xmoshte/list-tap/source/v4/production/bom.csv

Designator | Footprint | Quantity | Value | LCSC Part #
B2, B3 | PESD5V5C1BLYL | 2 | PESD5V5C1BLYL(TP) | C54194967
BT1 | BAT_BK-880 | 1 | MY-2450-02 | C2979177
C1, C2 | PXTE010M477E060STU | 2 | 470u 10V | C724264
C10, C11 | CAPC1005X04L | 2 | 22u 10V | C6119813
C12, C9 | CAPC1608X06L | 2 | 10u 25V | C96446
C16, C17, C18, C19, C20 | CAPC1005X04L | 5 | 100n 50V | C53084453
C21 | CAPC1005X04L | 1 | 10u 10V | C315248
C22 | CAPC1005X04L | 1 | 1u 16V | C29266
D4 | LED_0402_GREEN | 1 | GREEN | C74338
L1 | INDC2520X100N | 1 | 470n 5.5A | C54557079
R14 | RESC1005X04L | 1 | 100k | C60491
R15 | RESC1005X04L | 1 | 511k | C64042
R16 | RESC1005X04L | 1 | 91k | C852952
R17 | RESC1005X04L | 1 | 340k | C2933090
R18 | RESC1005X04L | 1 | 120k | C2909314
R19, R20, R21, R22, R23 | RESC1005X04L | 5 | 10k | C60490
R25 | RESC1005X04L | 1 | 1k | C106235
R3, R4 | RESC1005X04L | 2 | 22R | C114765
SW1, SW2 | SW2_SKRKAEE020_ALPS | 2 | SKRKAEE020 | C115357
SW3 | PTS815 | 1 | PTS815 SJM 250 SMTR LFS | C2689510
U1 | ESP32C3MINI1N4 | 1 | ESP32-C3-MINI-1-N4 | C2838502
U3 | SOT23-6L_STM | 1 | USBLC6-2SC6Y | C2969755
U5 | BGA15N40P5X3_225X134X62N | 1 | TPS63805YFFR | C2879615
