xmoshte/list-tap/source/v4/list-tap.kicad_pcb

## KiCad design source/v4/list-tap.kicad_pcb (2026-11-05)

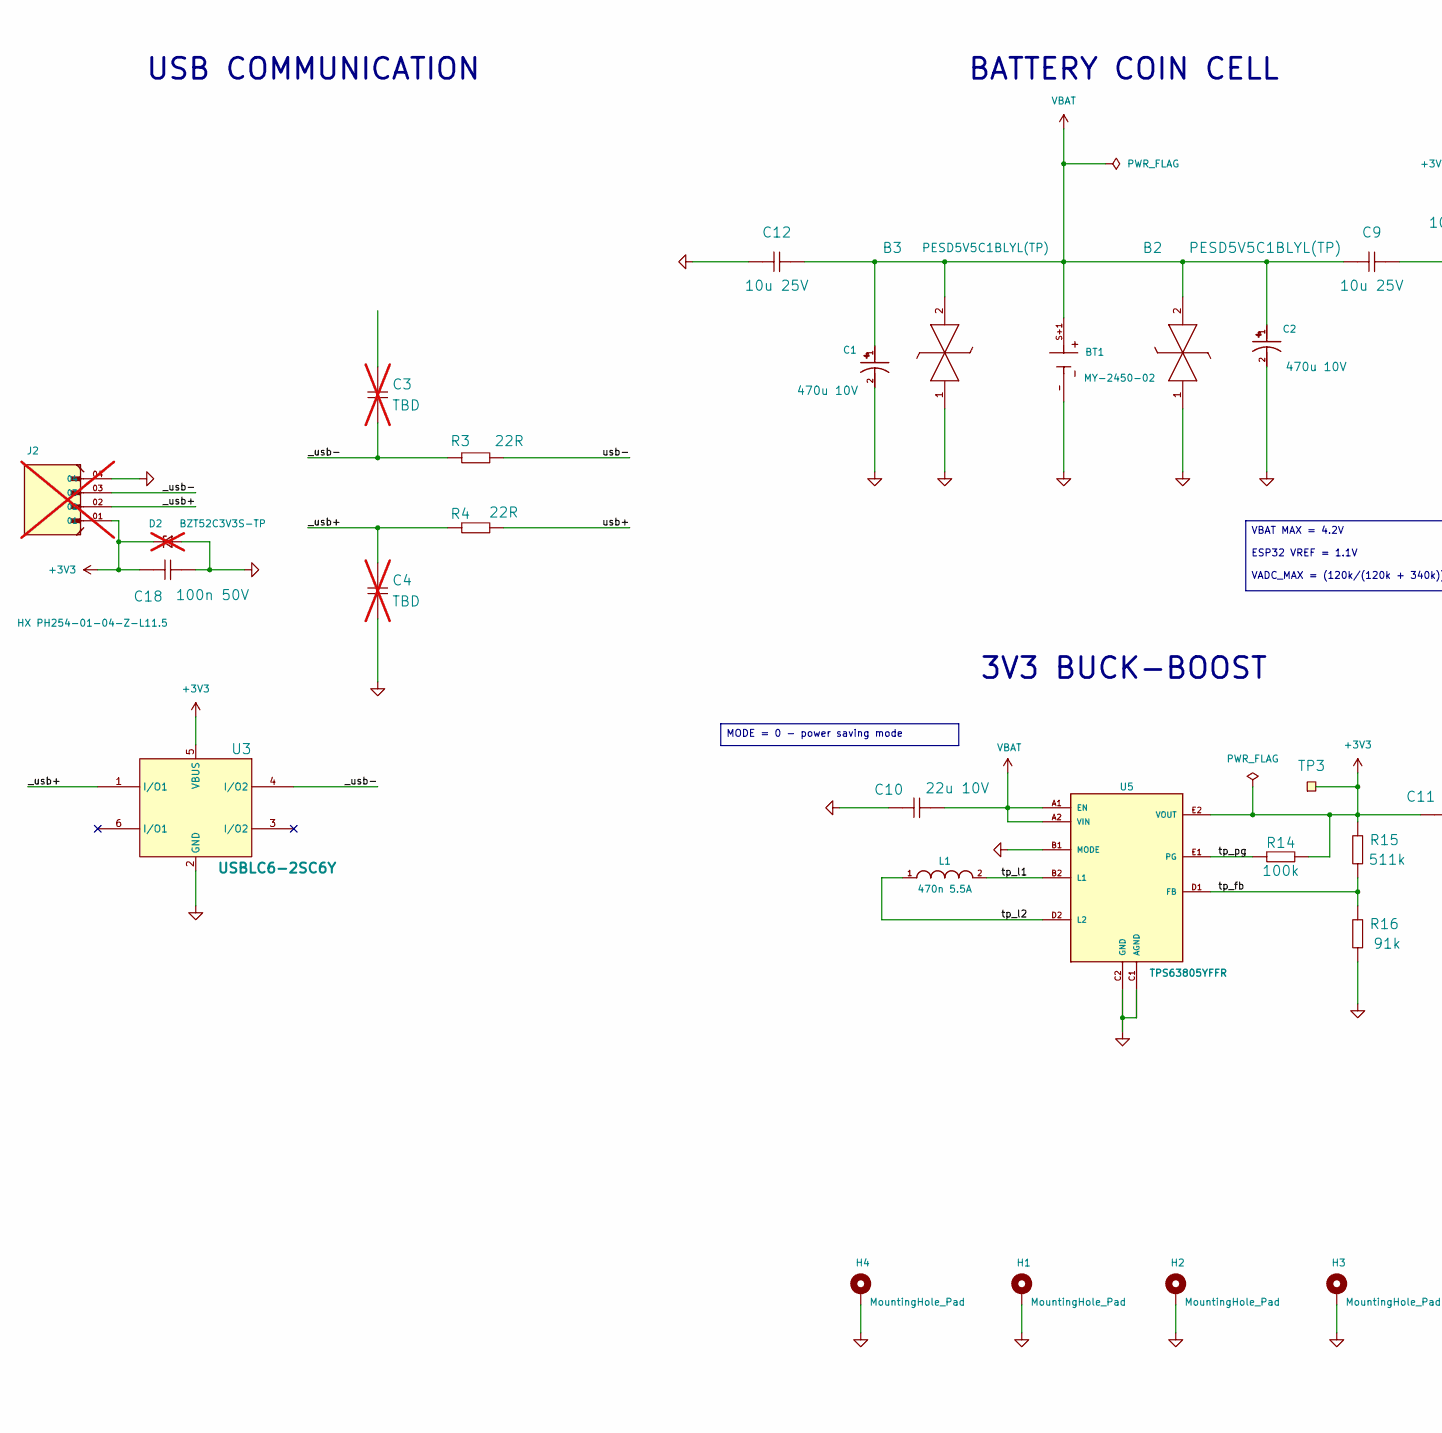
[picture p1: schematic list-tap.kicad_sch, part in row 1, column 1]

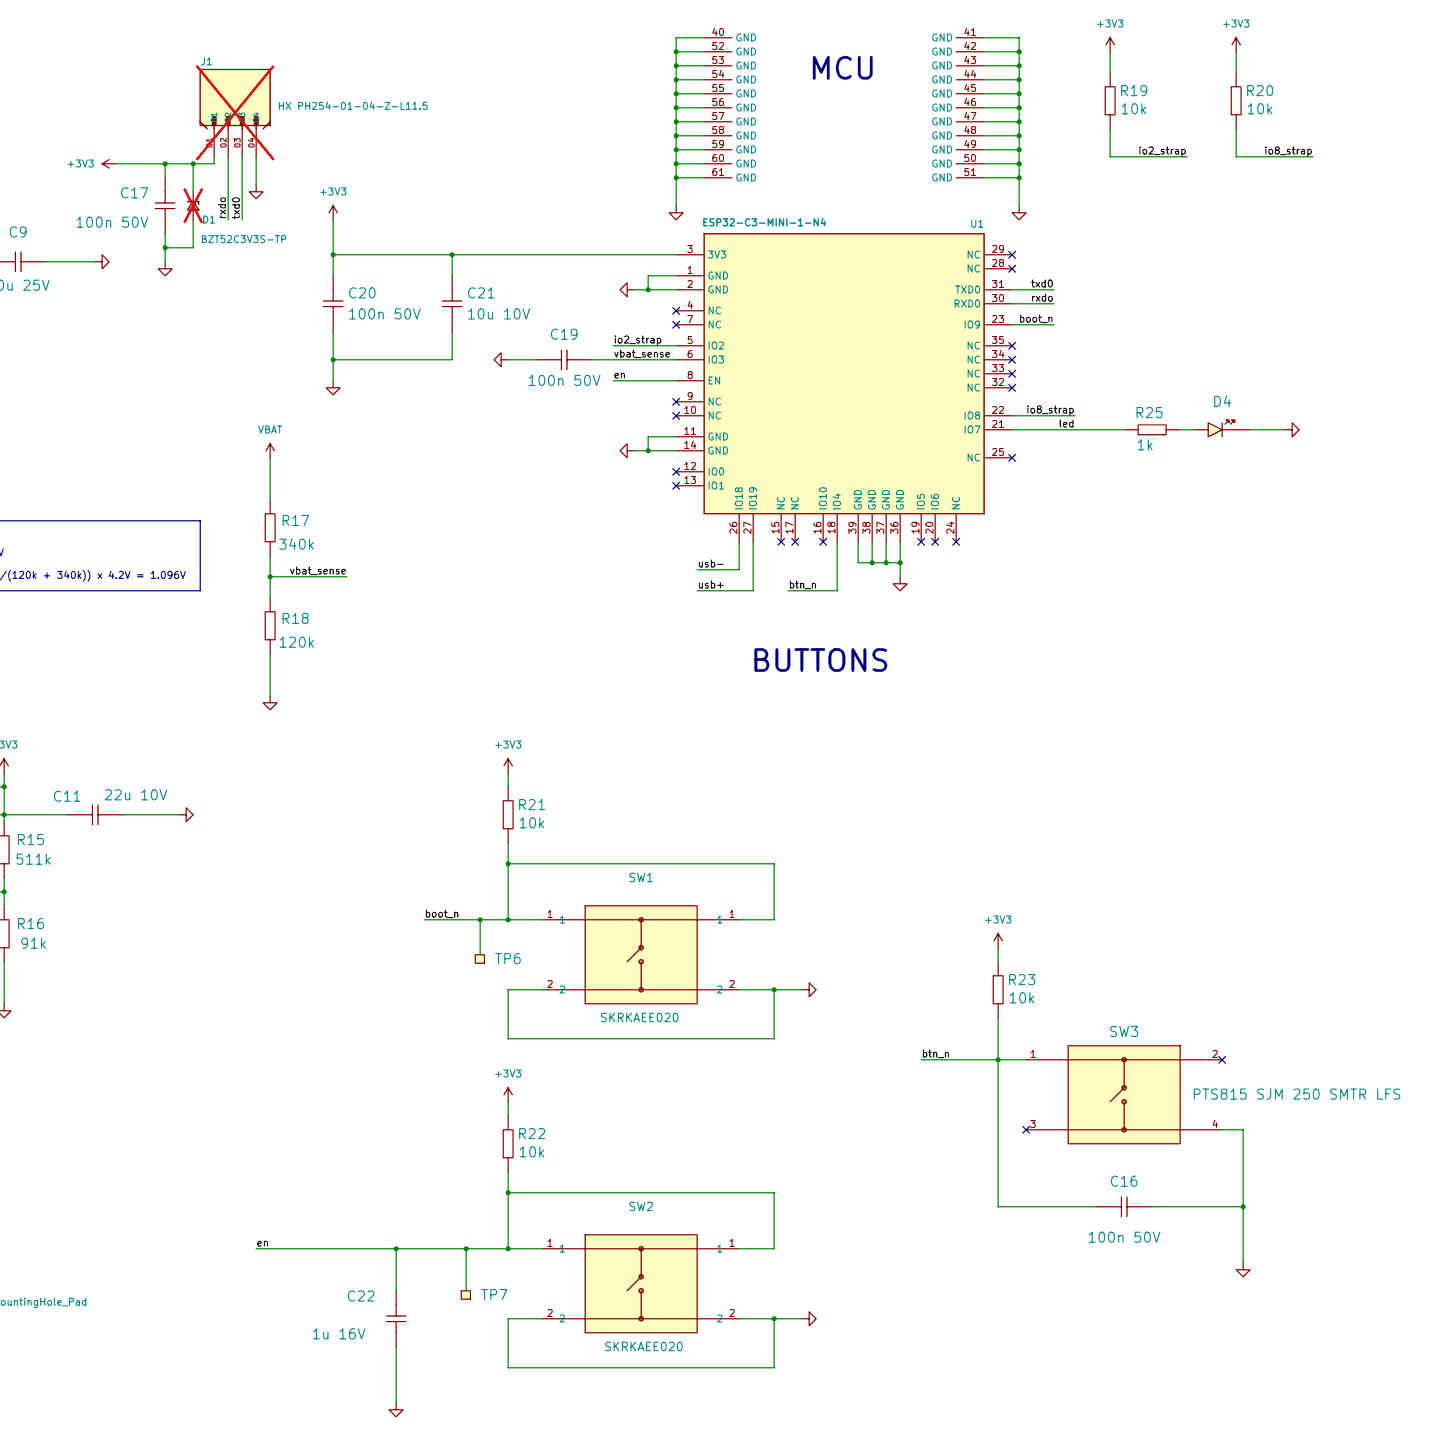
[picture p2: schematic list-tap.kicad_sch, part in row 1, column 2]

Parts:
B2, B3: PESD5V5C1BLYL(TP); PESD5V5C1BLYL; Manufacturer Part Number PESD5V5C1BLYL(TP); LCSC Part # C54194967
BT1: MY-2450-02; BAT_BK-880; Manufacturer Part Number MY-2450-02; LCSC Part # C2979177
C1, C2: 470u 10V; PXTE010M477E060STU; Manufacturer Part Number PXTE010M477E060STU; LCSC Part # C724264
C3, C4: TBD; CAPC1005X04L; not fitted
C9, C12: 10u 25V; CAPC1608X06L; Manufacturer Part Number CL10A106MA8NRNC; LCSC Part # C96446
C10, C11: 22u 10V; CAPC1005X04L; Manufacturer Part Number CGA0402X5R226M100GT; LCSC Part # C6119813
C16, C17, C18, C19, C20: 100n 50V; CAPC1005X04L; Manufacturer Part Number CC0402X7R50V104MN; LCSC Part # C53084453
C21: 10u 10V; CAPC1005X04L; Manufacturer Part Number CL05A106MP5NUNC; LCSC Part # C315248
C22: 1u 16V; CAPC1005X04L; Manufacturer Part Number CL05A105KO5NNNC; LCSC Part # C29266
D1, D2: BZT52C3V3S-TP; SOD2512X115N; Manufacturer Part Number BZT52C3V3S-TP; LCSC Part # C668900; not fitted
D4: GREEN; LED_0402_GREEN; Manufacturer Part Number 16-213/GHC-YR1S1/3T; LCSC Part # C74338
H1, H2, H3, H4: MountingHole_Pad; MountingHole_2.2mm_M2_Pad_Via
J1, J2: HX PH254-01-04-Z-L11.5; Manufacturer Part Number HX PH254-01-04-Z-L11.5; LCSC Part # C52016392; not fitted
L1: 470n 5.5A; INDC2520X100N; Manufacturer Part Number PCT252010-R47-M; LCSC Part # C54557079
R3, R4: 22R; RESC1005X04L; Manufacturer Part Number RC0402FR-0722RL; LCSC Part # C114765
R14: 100k; RESC1005X04L; Manufacturer Part Number RC0402FR-07100KL; LCSC Part # C60491
R15: 511k; RESC1005X04L; Manufacturer Part Number 0402WGF5113TCE; LCSC Part # C64042
R16: 91k; RESC1005X04L; Manufacturer Part Number RT0402BRD0791KL; LCSC Part # C852952
R17: 340k; RESC1005X04L; Manufacturer Part Number FRC0402F3403TS; LCSC Part # C2933090
R18: 120k; RESC1005X04L; Manufacturer Part Number FRC0402F1203TS; LCSC Part # C2909314
R19, R20, R21, R22, R23: 10k; RESC1005X04L; Manufacturer Part Number RC0402FR-0710KL; LCSC Part # C60490
R25: 1k; RESC1005X04L; Manufacturer Part Number RC0402FR-071KL; LCSC Part # C106235
SW1, SW2: SKRKAEE020; SW2_SKRKAEE020_ALPS; Manufacturer Part Number SKRKAEE020; LCSC Part # C115357
SW3: PTS815 SJM 250 SMTR LFS; PTS815; Manufacturer Part Number PTS815 SJM 250 SMTR LFS; LCSC Part # C2689510
TP3, TP6, TP7: Test Point; TP_SMD_D1.5mm; Part Number TP_SMD_Ø1.5MM
U1: ESP32-C3-MINI-1-N4; ESP32C3MINI1N4; Manufacturer Part Number ESP32-C3-MINI-1-N4; LCSC Part # C2838502
U3: USBLC6-2SC6Y; SOT23-6L_STM; Manufacturer Part Number USBLC6-2SC6Y; LCSC Part # C2969755
U5: TPS63805YFFR; BGA15N40P5X3_225X134X62N; Manufacturer Part Number TPS63805YFFR; LCSC Part # C2879615

Connections:
+3V3: C11.1, C17.2, C18.2, C20.2, C21.2, D1.K, D2.K, J1.01, J2.01, R14.2, R15.2, R19.2, R20.2, R21.2, R22.2, R23.2, TP3.1 (1_1), U1.3 (3V3), U3.5 (VBUS), U5.E2 (VOUT), U5.E3 (VOUT)
/_usb+: C4.2, J2.02, R4.1, U3.1 (I/O1)
/_usb-: C3.1 (1_1), J2.03, R3.1, U3.4 (I/O2)
/boot_n: R21.1, SW1.1, TP6.1 (1_1), U1.23 (IO9)
/btn_n: C16.2, R23.1, SW3.1, U1.18 (IO4)
/en: C22.1, R22.1, SW2.1, TP7.1 (1_1), U1.8 (EN)
/io2_strap: R19.1, U1.5 (IO2)
/io8_strap: R20.1, U1.22 (IO8)
/led: R25.2, U1.21 (IO7)
/rxdo: J1.02, U1.30 (RXD0)
/tp_fb: R15.1, R16.2, U5.D1 (FB)
/tp_l1: L1.2, U5.B2 (L1), U5.B3 (L1)
/tp_l2: L1.1, U5.D2 (L2), U5.D3 (L2)
/tp_pg: R14.1, U5.E1 (PG)
/txd0: J1.03, U1.31 (TXD0)
/usb+: R4.2, U1.27 (IO19)
/usb-: R3.2, U1.26 (IO18)
/vbat_sense: C19.2, R17.1, R18.2, U1.6 (IO3)
GND: B2.1 (K1), B3.1 (K1), BT1.-, C1.2, C2.2, C4.1, C9.2, C10.1, C11.2, C12.2, C16.1, C17.1, C18.1, C19.1, C20.1, C21.1, C22.2, D1.A, D2.A, D4.K, H1.1 (1_1), H2.1 (1_1), H3.1 (1_1), H4.1 (1_1), J1.04, J2.04, R16.1, R18.1, SW1.2, SW2.2, SW3.4, U1.1 (GND), U1.2 (GND), U1.11 (GND), U1.14 (GND), U1.36 (GND), U1.37 (GND), U1.38 (GND), U1.39 (GND), U1.40 (GND), U1.41 (GND), U1.42 (GND), U1.43 (GND), U1.44 (GND), U1.45 (GND), U1.46 (GND), U1.47 (GND), U1.48 (GND), U1.49 (GND), U1.50 (GND), U1.51 (GND), U1.52 (GND), U1.53 (GND), U1.54 (GND), U1.55 (GND), U1.56 (GND), U1.57 (GND), U1.58 (GND), U1.59 (GND), U1.60 (GND), U1.61 (GND), U3.2 (GND), U5.B1 (MODE), U5.C1 (AGND), U5.C2 (GND), U5.C3 (GND)
unnamed: D4.A, R25.1
VBAT: B2.2 (K2), B3.2 (K2), BT1.S+1, BT1.S+2, C1.1, C2.1, C9.1, C10.2, C12.1, R17.2, U5.A1 (EN), U5.A2 (VIN), U5.A3 (VIN)

Notes on the sheet:
3V3 BUCK-BOOST
USB COMMUNICATION
MCU
BUTTONS
BATTERY COIN CELL
VBAT MAX = 4.2V ESP32 VREF = 1.1V VADC_MAX = (120k/(120k + 340k)) x 4.2V = 1.096V
MODE = 0 - power saving mode

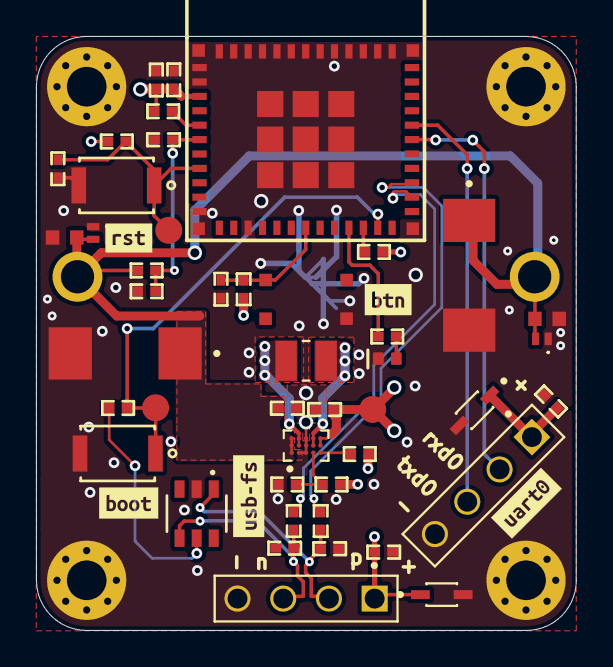
[picture p3: board list-tap.kicad_pcb from above]

Board: 2 copper layers, 30.0 x 33.0 mm, 55 parts (1 on the bottom side), 21 nets.

Other parts of the board:
kibuzzard-6AE057E3: G***; kibuzzard-6AE057E3
kibuzzard-6AE057F3: G***; kibuzzard-6AE057F3
kibuzzard-6AE0575D: G***; kibuzzard-6AE0575D
kibuzzard-6AE0576D: G***; kibuzzard-6AE0576D
kibuzzard-6AE0579C: G***; kibuzzard-6AE0579C
