xmoshte/list-tap/(commit log)

2026-10-21 schematics done awaiting revision
    [bom.csv, list-tap.kicad_sch]
2026-10-21 r2 changes
    [bom.csv, list-tap.kicad_sch]
2026-10-23 layout r1
    [bom.csv, list-tap.kicad_pcb, list-tap.kicad_sch]
2026-10-23 bom r2
    [bom.csv, list-tap.kicad_sch]
2026-10-23 schematics plot
2026-10-24 layout r3
    [list-tap.kicad_pcb, list-tap.kicad_sch]
2026-10-26 layout and routing r4
    [list-tap.kicad_pcb, list-tap.kicad_sch]
2026-10-27 v3 editions
    [bom.csv, list-tap.kicad_pcb, list-tap.kicad_sch]
2026-10-27 fabrication files prepared
    [bom.csv, designators.csv, list-tap.kicad_pcb, list-tap.kicad_sch, positions.csv]
2026-10-27 3v3 zener clamping
    [bom.csv, designators.csv, list-tap.kicad_pcb, list-tap.kicad_sch, positions.csv]
2026-10-27 L1 swap
    [bom.csv, list-tap.kicad_pcb, list-tap.kicad_sch]
2026-10-28 MY-2450-02 battery holder
    [bom.csv, list-tap.kicad_pcb, list-tap.kicad_sch, positions.csv]
2026-10-28 battery holder footprint
    [list-tap.kicad_pcb]
2026-10-30 v4. Resize. 30mm by 33mm
    [bom.csv, designators.csv, list-tap.kicad_pcb, list-tap.kicad_sch, positions.csv]
2026-10-31 rounded corners, DRC checks
    [bom.csv, designators.csv, list-tap.kicad_pcb, list-tap.kicad_sch, positions.csv]
2026-11-02 minor changes made
    [bom.csv, designators.csv, list-tap.kicad_pcb, list-tap.kicad_sch, positions.csv]
2026-11-04 power architecture
2026-11-05 x2 resevoiur caps added
    [bom.csv, designators.csv, list-tap.kicad_pcb, list-tap.kicad_sch, positions.csv]
